jmhigh2/micromouseIFC/python/maze2008.jpg

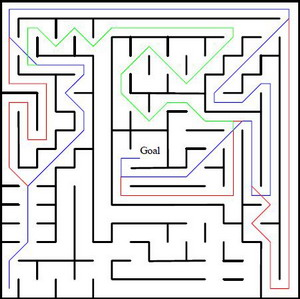
python/maze2008.jpg
