jmhigh2/micromouseIFC/GreenGiant_MIN7/Green Giant V4.2 Schematic.pdf

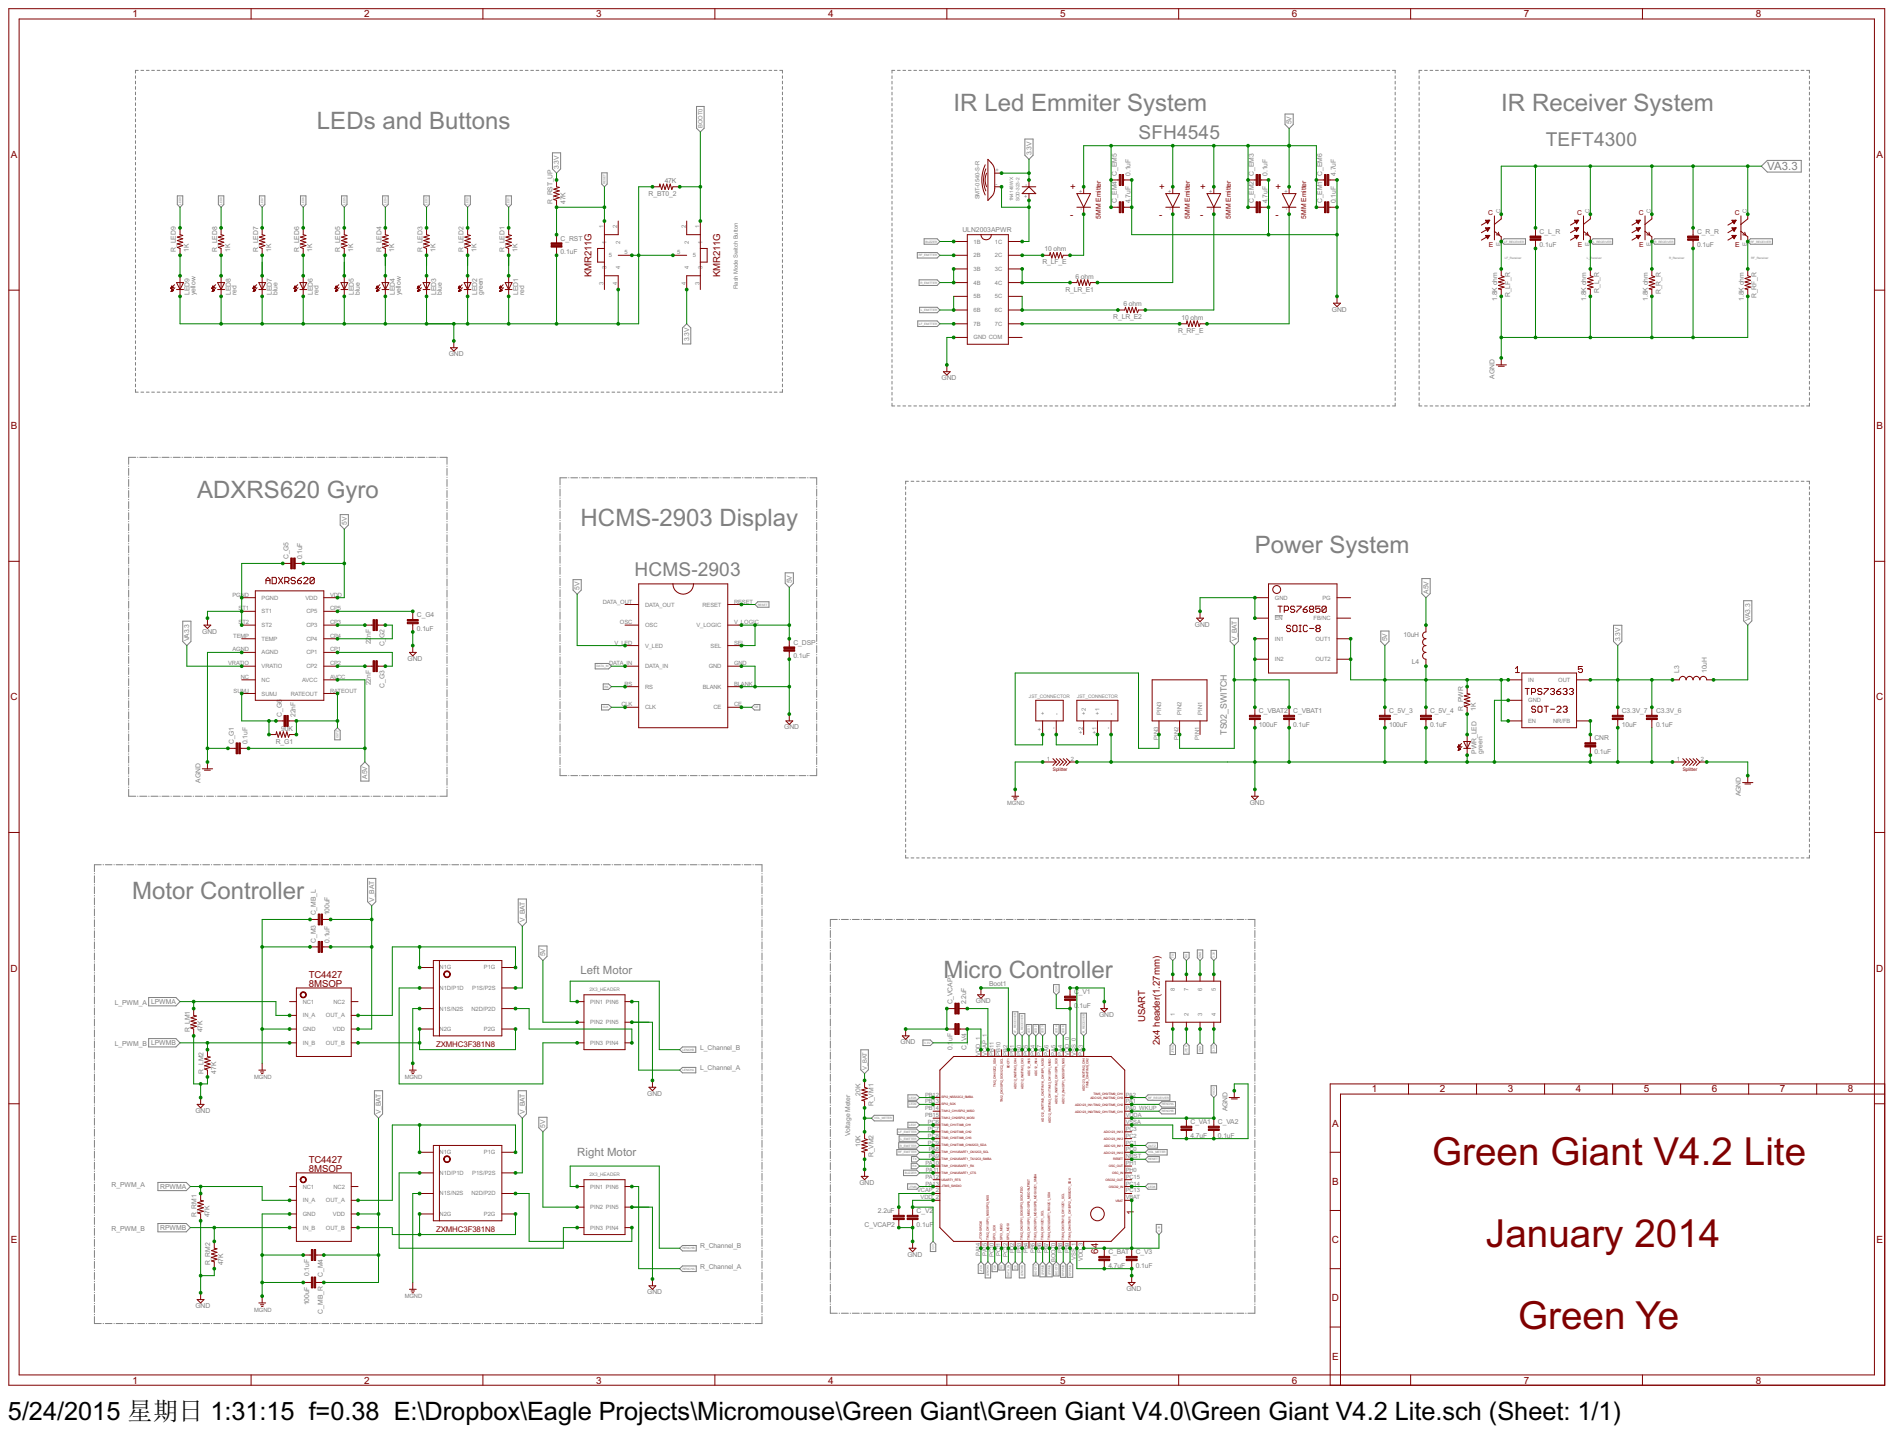
[picture p2: page 1]

MGND | LENCHB

5/24/2015 星期日 1:31:15 f=0.38 E:\Dropbox\Eagle Projects\Micromouse\Green Giant\Green Giant V4.0\Green Giant V4.2 Lite.sch (Sheet: 1/1)
