jmhigh2/micromouseIFC/GreenGiant_MIN7/MIN7-Schematic.pdf

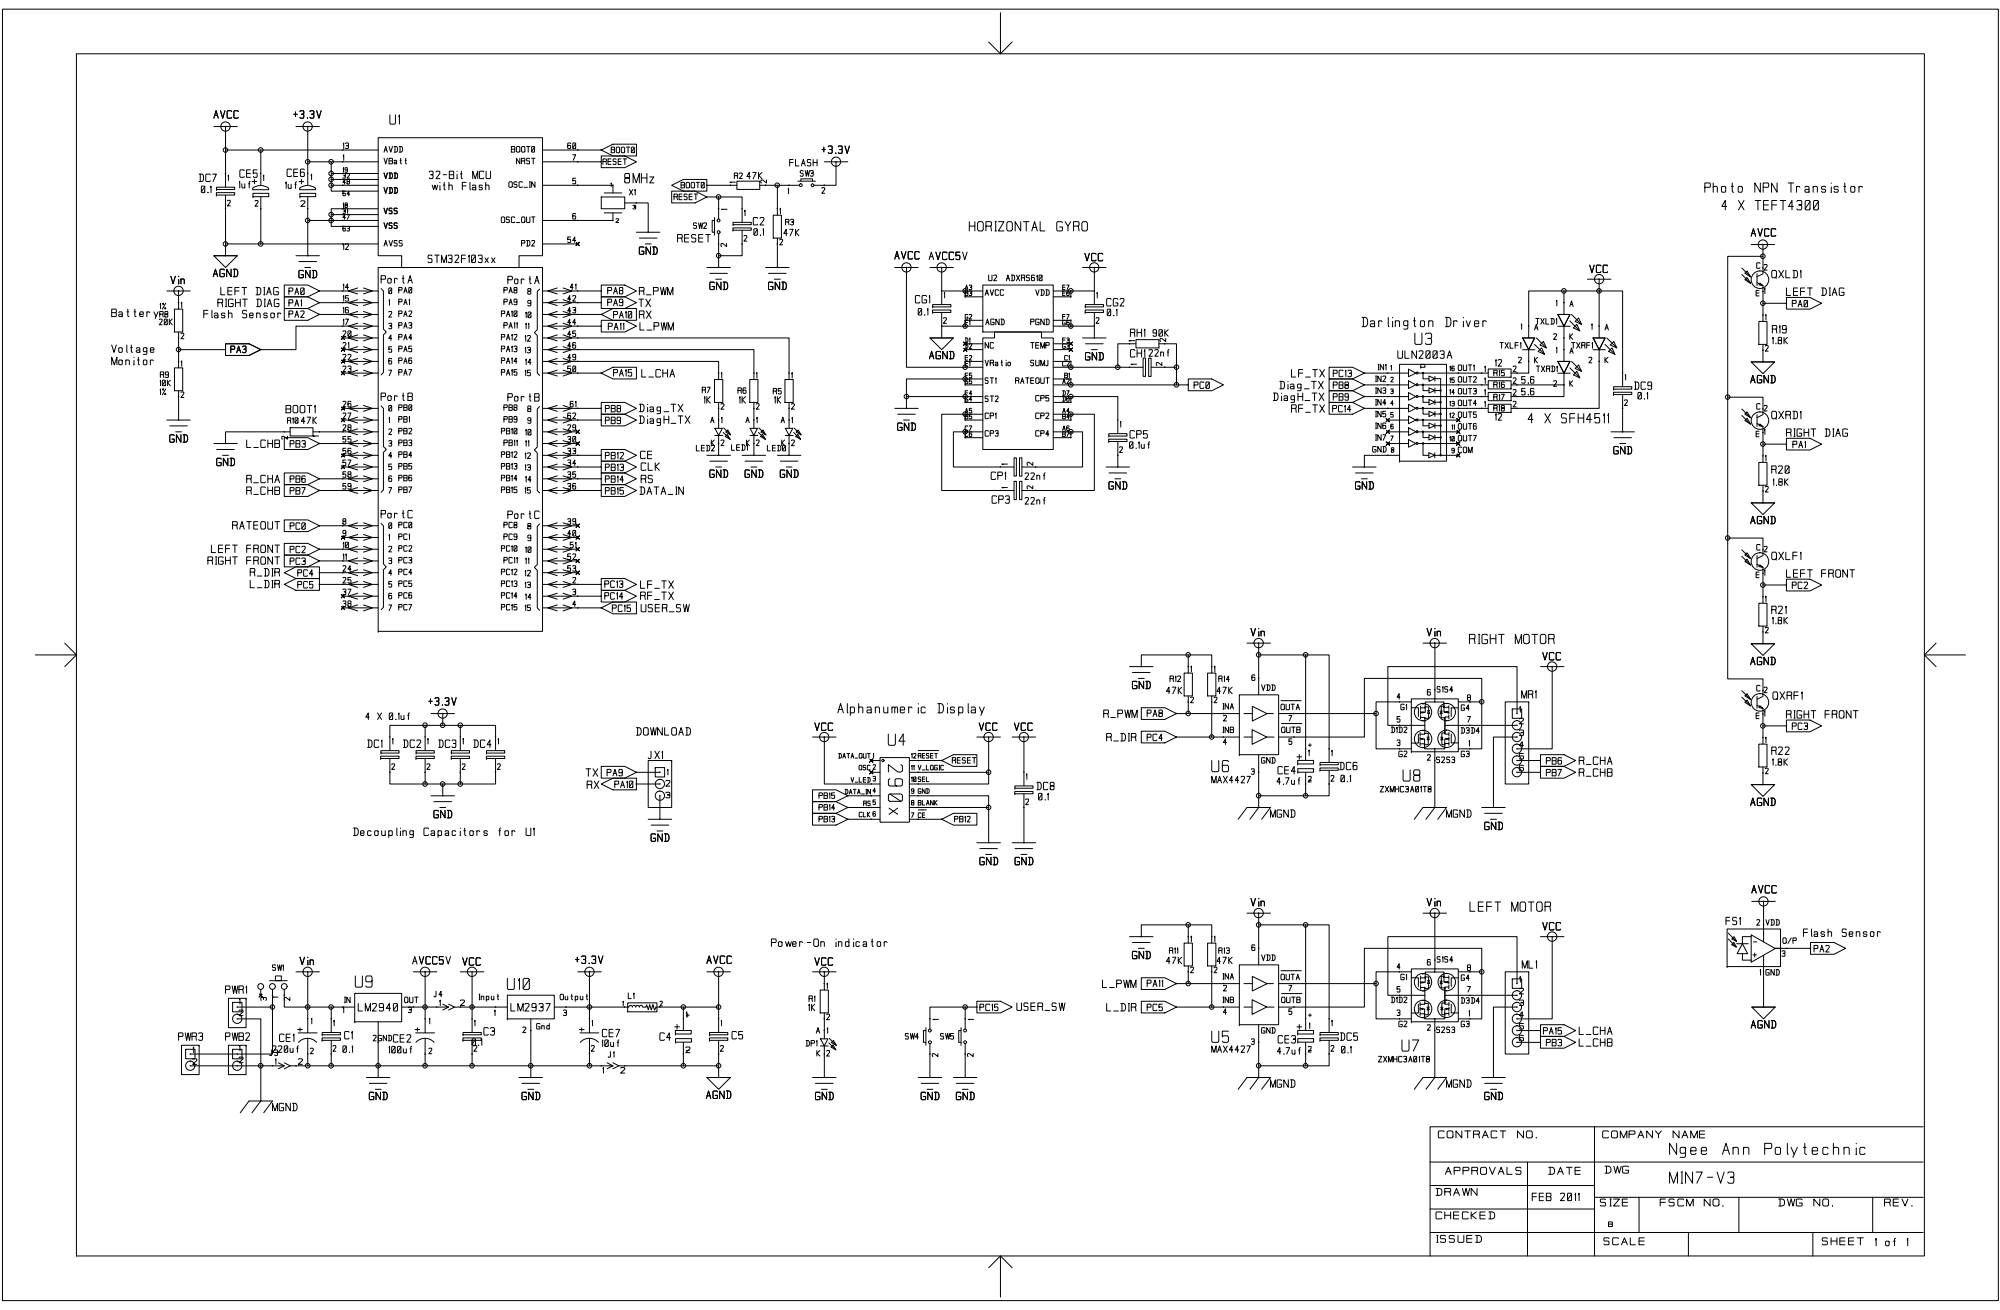
[picture p3: page 1]
