jmhigh2/micromouseIFC/MouseRev100000/MoueRev3.brd

## EAGLE design MouseRev100000/MoueRev3.brd (2017-03-13)

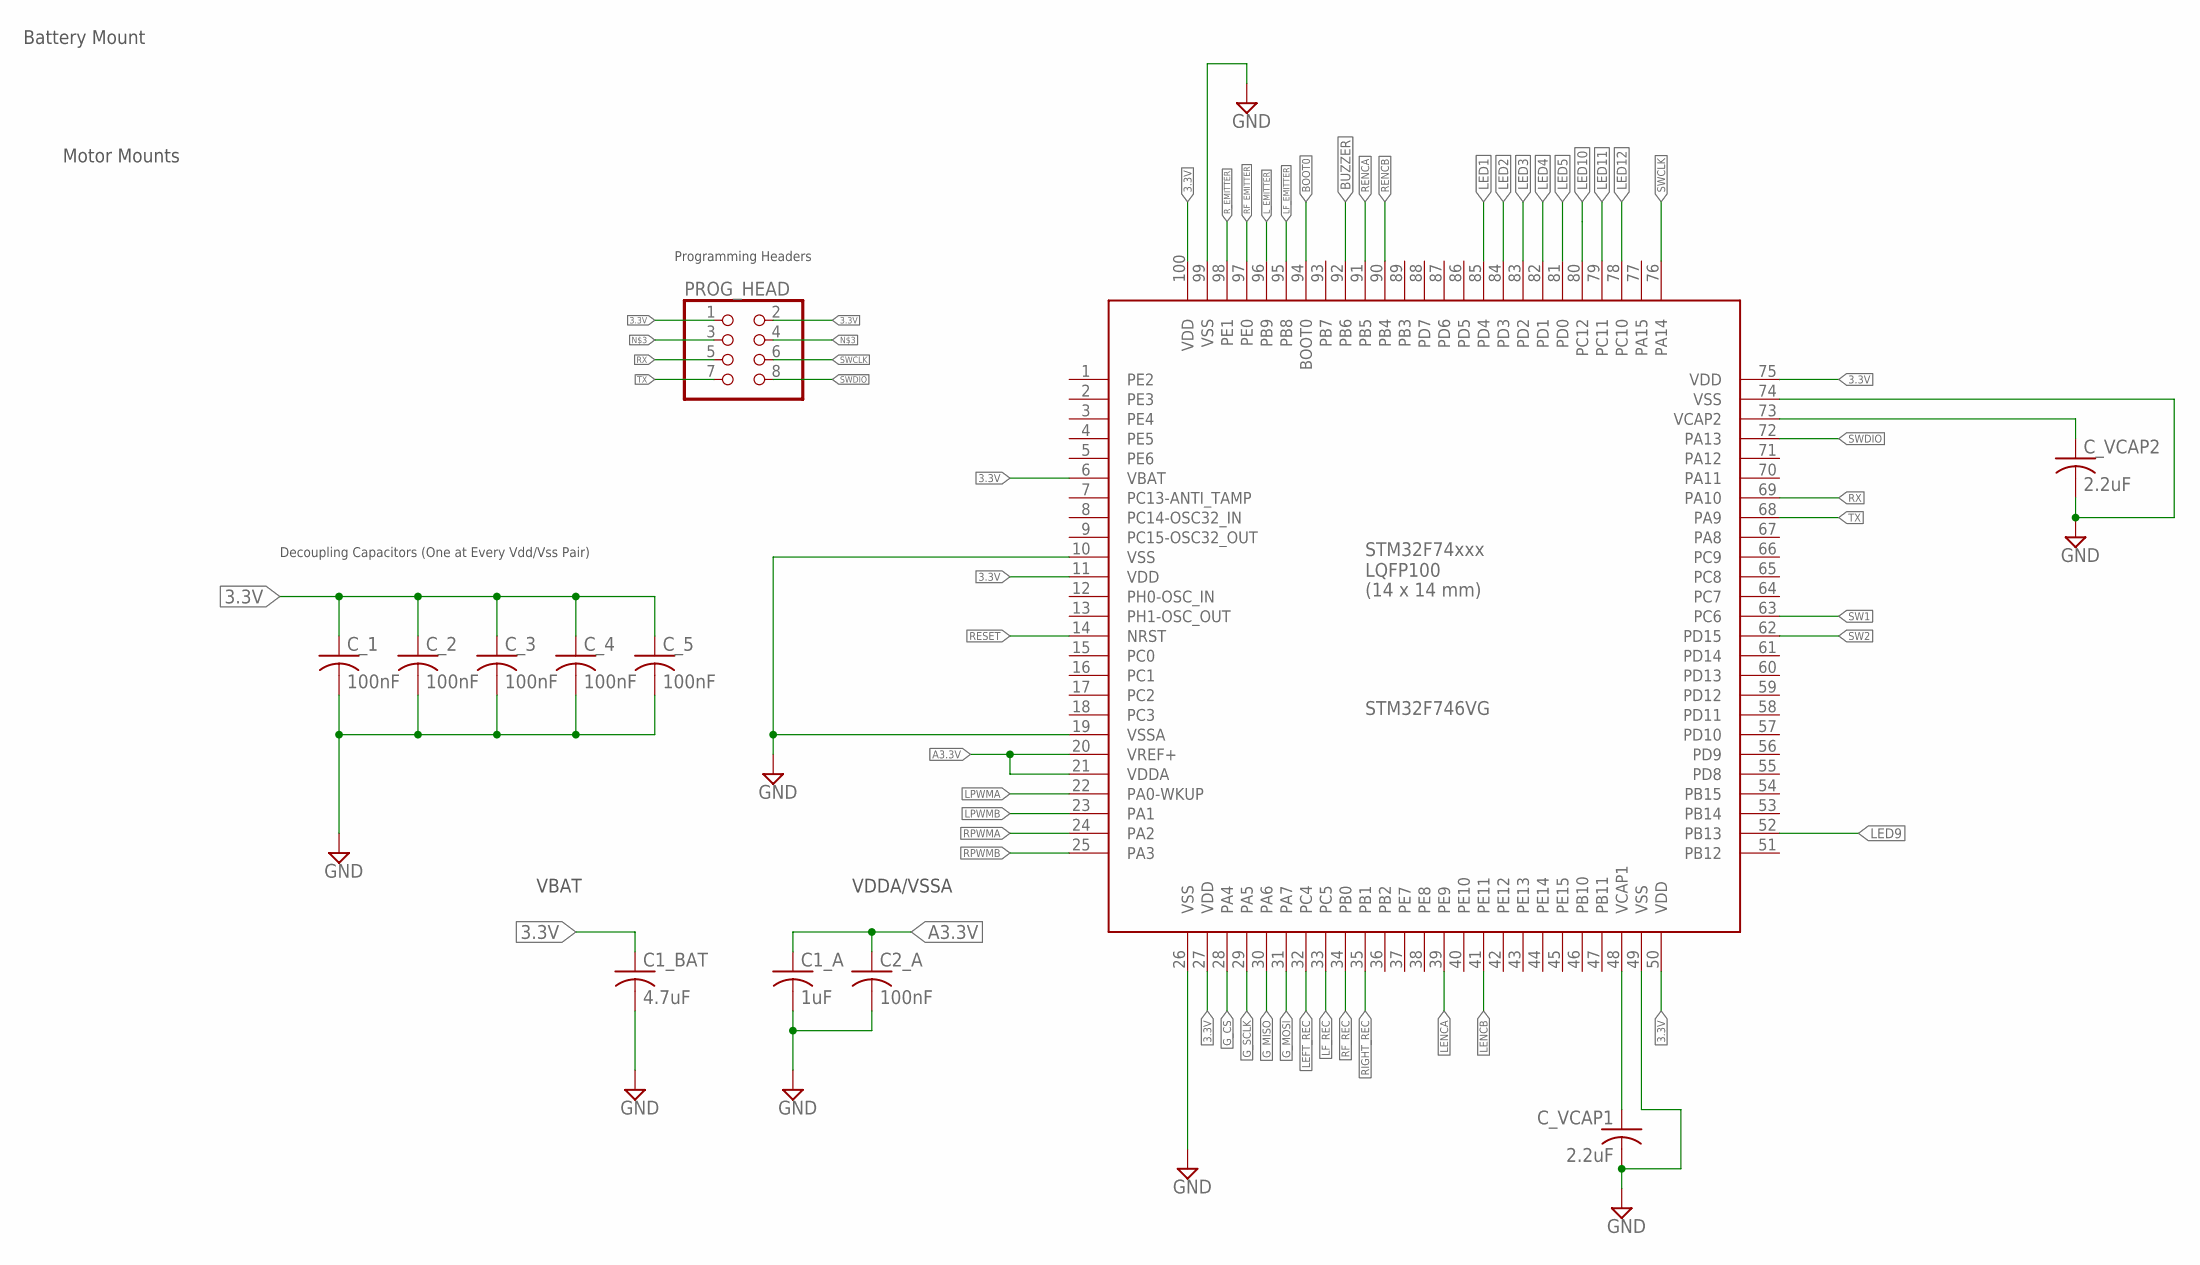
[picture p4: schematic MoueRev3.sch, sheet 1, MicroController]

Parts:
C1_A: 1uF; C0603
C1_BAT: 4.7uF; C0603
C2_A: 100nF; C0603
C_1, C_2, C_3, C_4, C_5: 100nF; C0603
C_VCAP1, C_VCAP2: 2.2uF; C0603
PROG_HEAD: PINHD-2X4; 2X04
U$2: MOTOR; MOTOR_MOUNT
U$3: STM32F746VG; LQFP100

Connections:
3.3V: C1_BAT.1, C_1.1, C_2.1, C_3.1, C_4.1, C_5.1, PROG_HEAD.1, PROG_HEAD.2, U$3.6 (VBAT), U$3.11 (VDD), U$3.27 (VDD), U$3.50 (VDD), U$3.75 (VDD), U$3.100 (VDD); also elsewhere on the board
A3.3V: C1_A.1, C2_A.1, U$3.20 (VREF+), U$3.21 (VDDA); also elsewhere on the board
BOOT0: U$3.94 (BOOT0); also elsewhere on the board
BUZZER: U$3.92 (PB6); also elsewhere on the board
G_CS: U$3.28 (PA4); also elsewhere on the board
G_MISO: U$3.30 (PA6); also elsewhere on the board
G_MOSI: U$3.31 (PA7); also elsewhere on the board
G_SCLK: U$3.29 (PA5); also elsewhere on the board
LED1: U$3.85 (PD4); also elsewhere on the board
LED2: U$3.84 (PD3); also elsewhere on the board
LED3: U$3.83 (PD2); also elsewhere on the board
LED4: U$3.82 (PD1); also elsewhere on the board
LED5: U$3.81 (PD0); also elsewhere on the board
LED9: U$3.52 (PB13); also elsewhere on the board
LED10: U$3.80 (PC12); also elsewhere on the board
LED11: U$3.79 (PC11); also elsewhere on the board
LED12: U$3.78 (PC10); also elsewhere on the board
LEFT_REC: U$3.32 (PC4); also elsewhere on the board
LENCA: U$3.39 (PE9); also elsewhere on the board
LENCB: U$3.41 (PE11); also elsewhere on the board
LF_EMITTER: U$3.95 (PB8); also elsewhere on the board
LF_REC: U$3.33 (PC5); also elsewhere on the board
LPWMA: U$3.22 (PA0-WKUP); also elsewhere on the board
LPWMB: U$3.23 (PA1); also elsewhere on the board
L_EMITTER: U$3.96 (PB9); also elsewhere on the board
unnamed 30: C1_A.2, C1_BAT.2, C2_A.2, C_1.2, C_2.2, C_3.2, C_4.2, C_5.2, C_VCAP1.2, C_VCAP2.2, PROG_HEAD.3, PROG_HEAD.4, U$3.10 (VSS), U$3.19 (VSSA), U$3.26 (VSS), U$3.49 (VSS), U$3.74 (VSS), U$3.99 (VSS); also elsewhere on the board
unnamed: C_VCAP2.1, U$3.73 (VCAP2)
unnamed: C_VCAP1.1, U$3.48 (VCAP1)
RENCA: U$3.91 (PB5); also elsewhere on the board
RENCB: U$3.90 (PB4); also elsewhere on the board
RESET: U$3.14 (NRST); also elsewhere on the board
RF_EMITTER: U$3.97 (PE0); also elsewhere on the board
RF_REC: U$3.34 (PB0); also elsewhere on the board
RIGHT_REC: U$3.35 (PB1); also elsewhere on the board
RPWMA: U$3.24 (PA2); also elsewhere on the board
RPWMB: U$3.25 (PA3); also elsewhere on the board
RX: PROG_HEAD.5, U$3.69 (PA10)
R_EMITTER: U$3.98 (PE1); also elsewhere on the board
SW1: U$3.63 (PC6)
SW2: U$3.62 (PD15)
SWCLK: PROG_HEAD.6, U$3.76 (PA14)
SWDIO: PROG_HEAD.8, U$3.72 (PA13)
TX: PROG_HEAD.7, U$3.68 (PA9)

Notes on the sheet:
Decoupling Capacitors (One at Every Vdd/Vss Pair)
Programming Headers
VDDA/VSSA
VBAT
Battery Mount
Motor Mounts

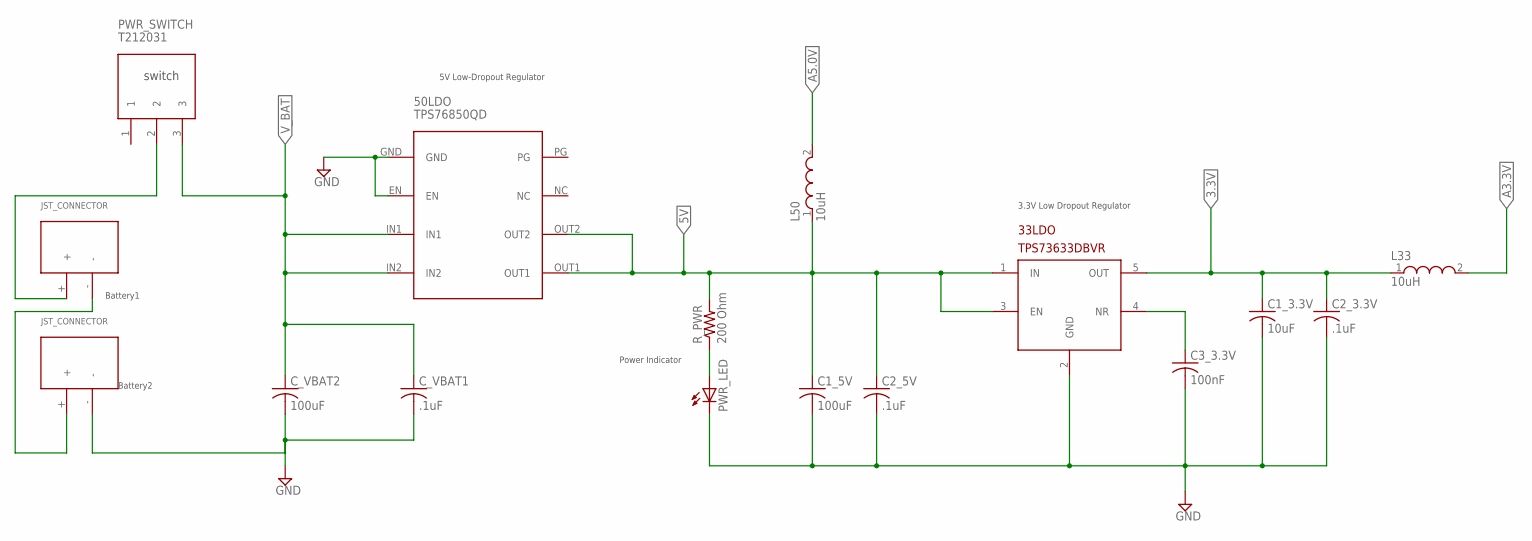
[picture p5: schematic MoueRev3.sch, sheet 2, Power Supply]

Parts:
33LDO: TPS73633DBVR; SOT23-DBV
50LDO: TPS76850QD; 8-SOIC(SMT)
C1_3.3V: 10uF; C0603
C1_5V: 100uF; C0603
C2_3.3V, C2_5V: .1uF; C0603
C3_3.3V: 100nF; C0603
C_VBAT1: .1uF; C0603
C_VBAT2: 100uF; C1206
L33, L50: 10uH; WE-MI_0805
PWR_LED: LEDCHIPLED_0805; CHIPLED_0805
PWR_SWITCH: T212031
R_PWR: 200 Ohm; R0603
U$7, U$8: JST_CONNECTOR_FEMALE

Connections:
3.3V: 33LDO.5 (OUT), C1_3.3V.1, C2_3.3V.1, L33.1; also elsewhere on the board
5V: 33LDO.1 (IN), 33LDO.3 (EN), 50LDO.OUT1, 50LDO.OUT2, C1_5V.1, C2_5V.1, L50.1, R_PWR.2; also elsewhere on the board
A3.3V: L33.2; also elsewhere on the board
A5.0V: L50.2; also elsewhere on the board
unnamed: PWR_LED.A, R_PWR.1
unnamed: 33LDO.4 (NR), C3_3.3V.1
unnamed 30: 33LDO.2 (GND), 50LDO.EN, 50LDO.GND, C1_3.3V.2, C1_5V.2, C2_3.3V.2, C2_5V.2, C3_3.3V.2, C_VBAT1.2, C_VBAT2.2, PWR_LED.C, U$8.-; also elsewhere on the board
unnamed: U$7.-, U$8.+
unnamed: PWR_SWITCH.2, U$7.+
V_BAT: 50LDO.IN1, 50LDO.IN2, C_VBAT1.1, C_VBAT2.1, PWR_SWITCH.3; also elsewhere on the board

Notes on the sheet:
Battery1
Battery2
5V Low-Dropout Regulator
3.3V Low Dropout Regulator
Power Indicator
switch

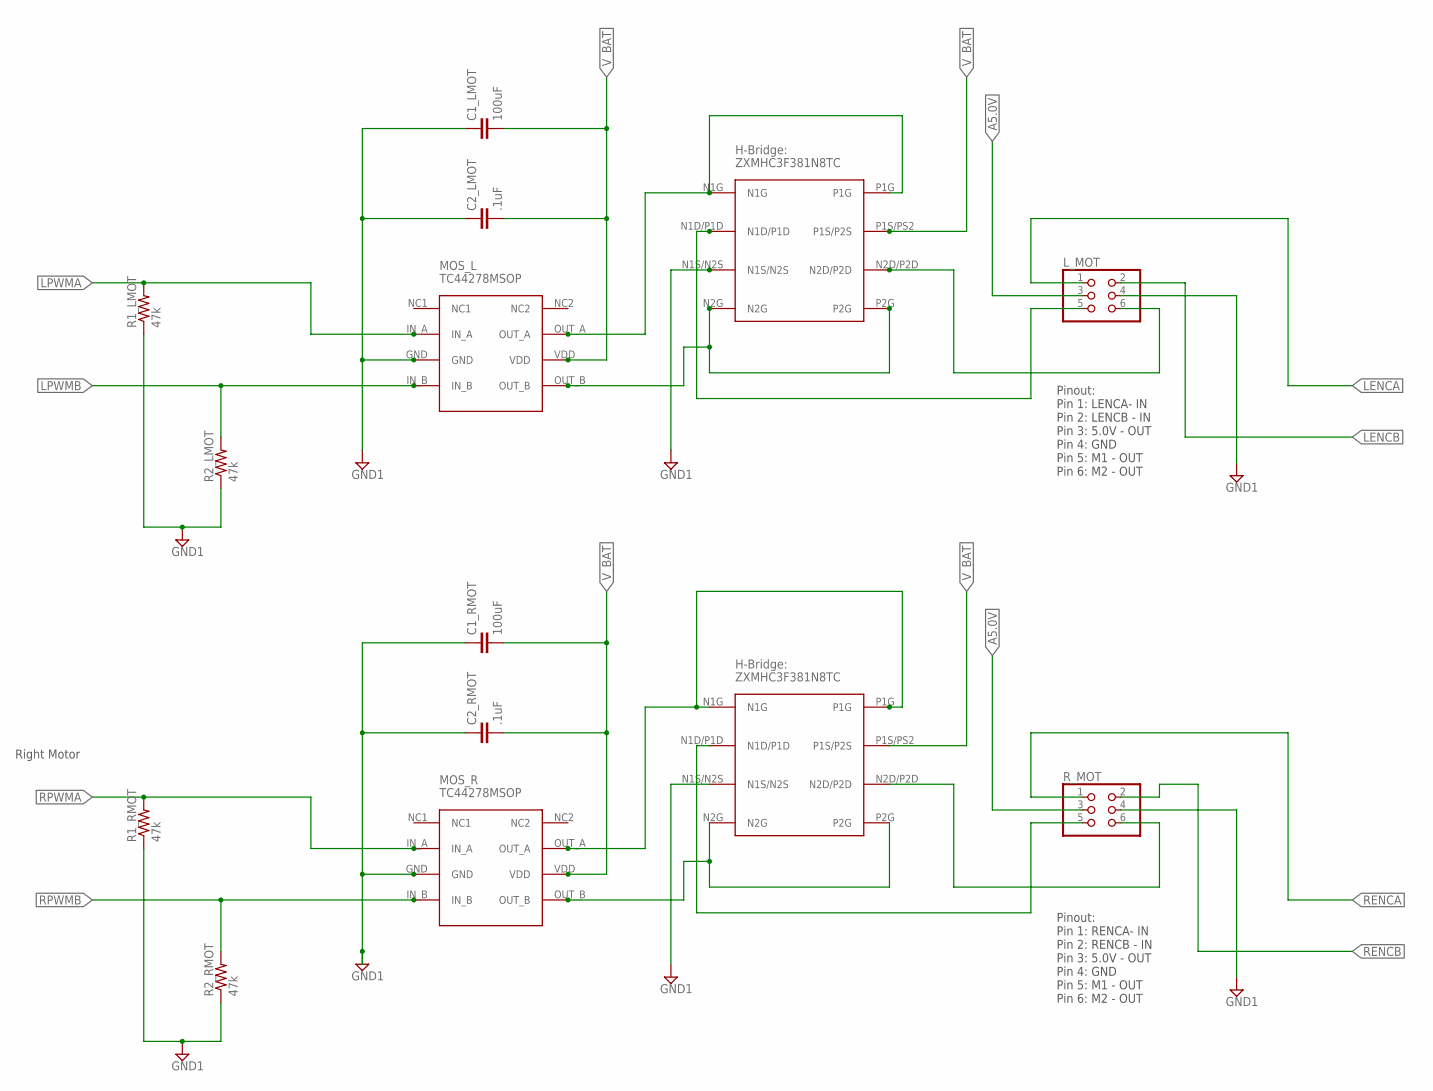
[picture p6: schematic MoueRev3.sch, sheet 3, Motor Control]

Parts:
C1_LMOT, C1_RMOT: 100uF; C1206
C2_LMOT, C2_RMOT: .1uF; C0805
HB_L: ZXMHC3F381N8TC; 8-SOIC
HB_R: ZXMHC3F381N8TC; 8-SOIC
L_MOT: PINHD-2X3; 2X03
MOS_L: TC44278MSOP
MOS_R: TC44278MSOP
R1_LMOT, R1_RMOT, R2_LMOT, R2_RMOT: 47k; R0603
R_MOT: PINHD-2X3; 2X03

Connections:
A5.0V: L_MOT.3, R_MOT.3; also elsewhere on the board
LENCA: L_MOT.1; also elsewhere on the board
LENCB: L_MOT.2; also elsewhere on the board
LPWMA: MOS_L.IN_A, R1_LMOT.2; also elsewhere on the board
LPWMB: MOS_L.IN_B, R2_LMOT.2; also elsewhere on the board
unnamed 30: C1_LMOT.1, C1_RMOT.1, C2_LMOT.1, C2_RMOT.1, HB_L.N1S/N2S, HB_R.N1S/N2S, L_MOT.4, MOS_L.GND, MOS_R.GND, R1_LMOT.1, R1_RMOT.1, R2_LMOT.1, R2_RMOT.1, R_MOT.4; also elsewhere on the board
unnamed: HB_L.N1G, HB_L.P1G, MOS_L.OUT_A
unnamed: HB_L.N2G, HB_L.P2G, MOS_L.OUT_B
unnamed: HB_R.N1G, HB_R.P1G, MOS_R.OUT_A
unnamed: HB_L.N1D/P1D, L_MOT.5
unnamed: HB_L.N2D/P2D, L_MOT.6
unnamed: HB_R.N2G, HB_R.P2G, MOS_R.OUT_B
unnamed: HB_R.N1D/P1D, R_MOT.5
unnamed: HB_R.N2D/P2D, R_MOT.6
RENCA: R_MOT.1; also elsewhere on the board
RENCB: R_MOT.2; also elsewhere on the board
RPWMA: MOS_R.IN_A, R1_RMOT.2; also elsewhere on the board
RPWMB: MOS_R.IN_B, R2_RMOT.2; also elsewhere on the board
V_BAT: C1_LMOT.2, C1_RMOT.2, C2_LMOT.2, C2_RMOT.2, HB_L.P1S/PS2 (P1S/P2S), HB_R.P1S/PS2 (P1S/P2S), MOS_L.VDD, MOS_R.VDD; also elsewhere on the board

Notes on the sheet:
Pinout: Pin 1: LENCA- IN Pin 2: LENCB - IN Pin 3: 5.0V - OUT Pin 4: GND Pin 5: M1 - OUT Pin 6: M2 - OUT
Right Motor
Pinout: Pin 1: RENCA- IN Pin 2: RENCB - IN Pin 3: 5.0V - OUT Pin 4: GND Pin 5: M1 - OUT Pin 6: M2 - OUT

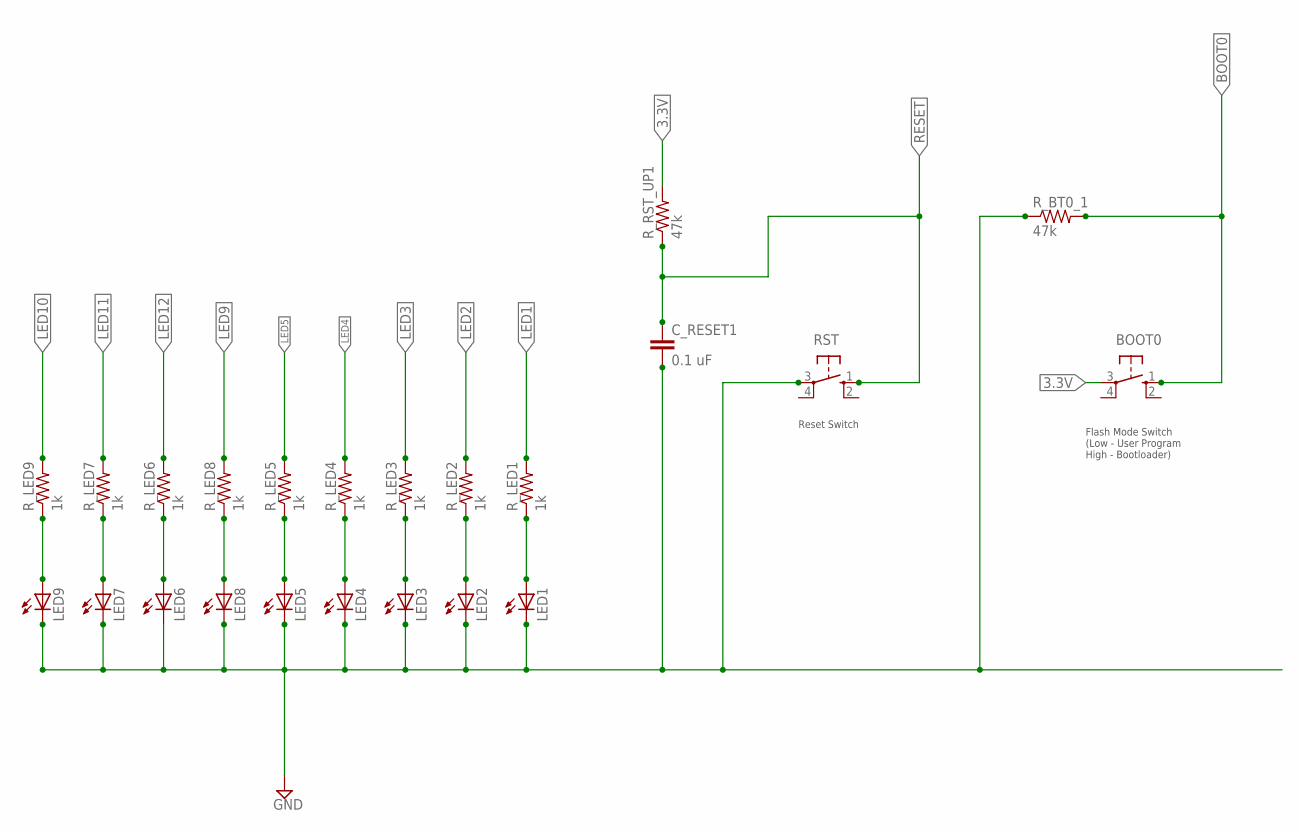
[picture p7: schematic MoueRev3.sch, sheet 4, LED's and Buttons]

Parts:
BOOT0: 10-XX; B3F-10XX
C_RESET1: 0.1 uF; C0603
LED1, LED2, LED3, LED4, LED5, LED6, LED7, LED8, LED9: LEDCHIPLED_0805; CHIPLED_0805
RST: 10-XX; B3F-10XX
R_BT0_1: 47k; R0603
R_LED1, R_LED2, R_LED3, R_LED4, R_LED5, R_LED6, R_LED7, R_LED8, R_LED9: 1k; R0603
R_RST_UP1: 47k; R0603

Connections:
3.3V: BOOT0.3, R_RST_UP1.2; also elsewhere on the board
BOOT0: BOOT0.1 (S), R_BT0_1.2; also elsewhere on the board
GND: C_RESET1.2, LED1.C, LED2.C, LED3.C, LED4.C, LED5.C, LED6.C, LED7.C, LED8.C, LED9.C, RST.3, R_BT0_1.1
LED1: R_LED1.2; also elsewhere on the board
LED2: R_LED2.2; also elsewhere on the board
LED3: R_LED3.2; also elsewhere on the board
LED4: R_LED4.2; also elsewhere on the board
LED5: R_LED5.2; also elsewhere on the board
LED9: R_LED8.2; also elsewhere on the board
LED10: R_LED9.2; also elsewhere on the board
LED11: R_LED7.2; also elsewhere on the board
LED12: R_LED6.2; also elsewhere on the board
unnamed: LED8.A, R_LED8.1
unnamed: LED6.A, R_LED6.1
unnamed: LED7.A, R_LED7.1
unnamed: LED9.A, R_LED9.1
unnamed: LED1.A, R_LED1.1
unnamed: LED2.A, R_LED2.1
unnamed: LED3.A, R_LED3.1
unnamed: LED4.A, R_LED4.1
unnamed: LED5.A, R_LED5.1
RESET: C_RESET1.1, RST.1 (S), R_RST_UP1.1; also elsewhere on the board

Notes on the sheet:
Reset Switch
Flash Mode Switch (Low - User Program High - Bootloader)

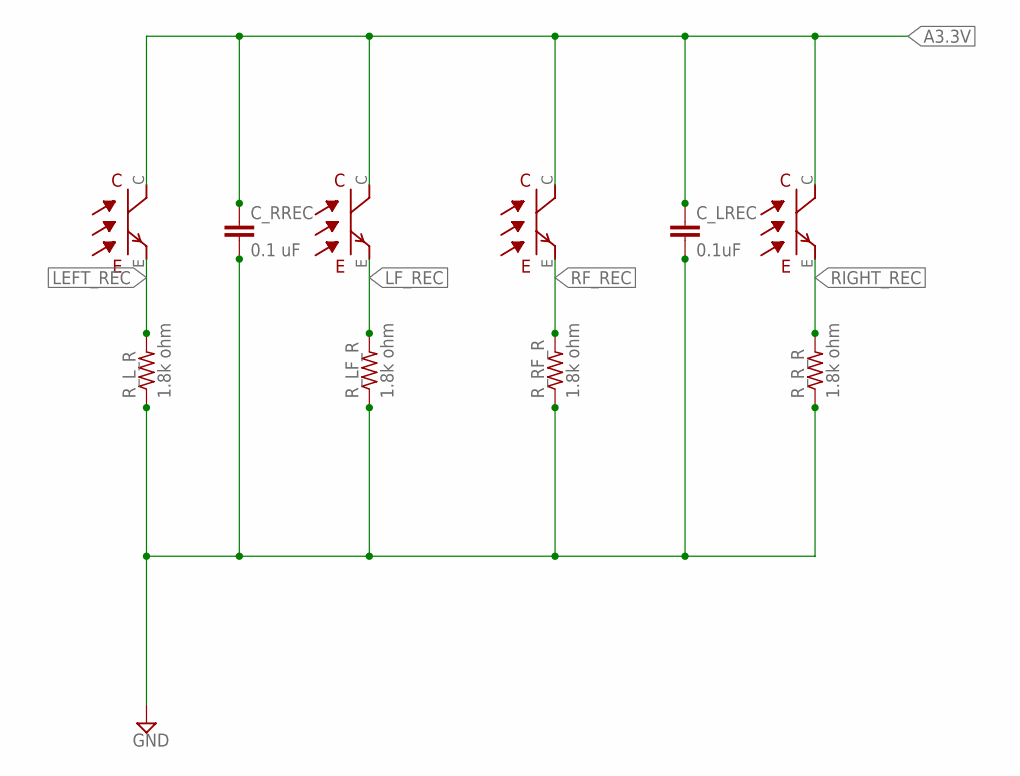
[picture p8: schematic MoueRev3.sch, sheet 5, Infrared Receivers]

Parts:
C_LREC: 0.1uF; C0603
C_RREC: 0.1 uF; C0603
LF_REC: RECEIVER
L_REC: RECEIVER
RF_REC: RECEIVER
R_LF_R: 1.8k ohm; R0603
R_L_R: 1.8k ohm; R0603
R_REC: RECEIVER
R_RF_R: 1.8k ohm; R0603
R_R_R: 1.8k ohm; R0603

Connections:
A3.3V: C_LREC.1, C_RREC.1, LF_REC.C, L_REC.C, RF_REC.C, R_REC.C; also elsewhere on the board
LEFT_REC: L_REC.E, R_L_R.2; also elsewhere on the board
LF_REC: LF_REC.E, R_LF_R.2; also elsewhere on the board
unnamed 30: C_LREC.2, C_RREC.2, R_LF_R.1, R_L_R.1, R_RF_R.1, R_R_R.1; also elsewhere on the board
RF_REC: RF_REC.E, R_RF_R.2; also elsewhere on the board
RIGHT_REC: R_REC.E, R_R_R.2; also elsewhere on the board

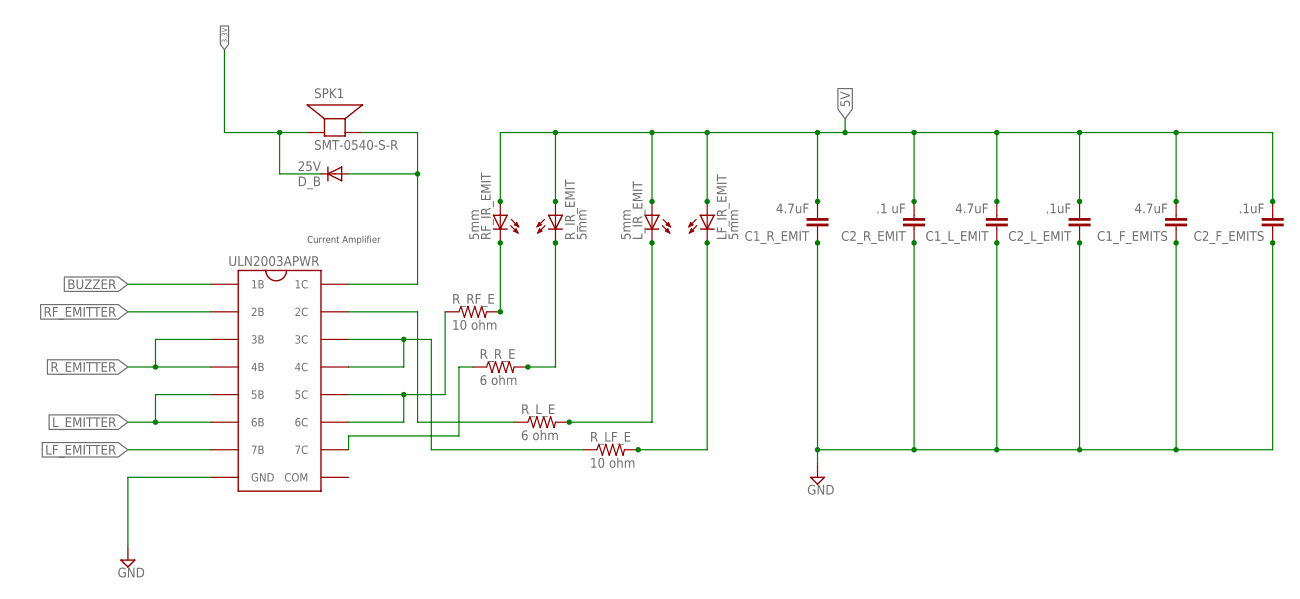
[picture p9: schematic MoueRev3.sch, sheet 6, Infrared Emitters]

Parts:
C1_F_EMITS, C1_L_EMIT, C1_R_EMIT: 4.7uF; C0603
C2_F_EMITS, C2_L_EMIT: .1uF; C0603
C2_R_EMIT: .1 uF; C0603
D_B: 25V; SOD123
LF_IR_EMIT: 5mm; LED5MM
L_IR_EMIT: 5mm; LED5MM
RF_IR_EMIT: 5mm; LED5MM
R_IR_EMIT: 5mm; LED5MM
R_LF_E: 10 ohm; R0603
R_L_E: 6 ohm; R0603
R_RF_E: 10 ohm; R0603
R_R_E: 6 ohm; R0603
SPK1: SMT-0540-S-R
U$9: ULN2003APWR

Connections:
3.3V: D_B.C, SPK1.- (+); also elsewhere on the board
5V: C1_F_EMITS.2, C1_L_EMIT.2, C1_R_EMIT.2, C2_F_EMITS.2, C2_L_EMIT.2, C2_R_EMIT.2, LF_IR_EMIT.A, L_IR_EMIT.A, RF_IR_EMIT.A, R_IR_EMIT.A; also elsewhere on the board
BUZZER: U$9.1B; also elsewhere on the board
LF_EMITTER: U$9.7B; also elsewhere on the board
L_EMITTER: U$9.5B, U$9.6B; also elsewhere on the board
unnamed 30: C1_F_EMITS.1, C1_L_EMIT.1, C1_R_EMIT.1, C2_F_EMITS.1, C2_L_EMIT.1, C2_R_EMIT.1, U$9.GND; also elsewhere on the board
unnamed: R_L_E.1, U$9.2C
unnamed: R_R_E.1, U$9.7C
unnamed: RF_IR_EMIT.K (C), R_RF_E.2
unnamed: R_LF_E.1, U$9.3C, U$9.4C
unnamed: R_IR_EMIT.K (C), R_R_E.2
unnamed: L_IR_EMIT.K (C), R_L_E.2
unnamed: R_RF_E.1, U$9.5C, U$9.6C
unnamed: LF_IR_EMIT.K (C), R_LF_E.2
unnamed: D_B.A, SPK1.+ (-), U$9.1C
RF_EMITTER: U$9.2B; also elsewhere on the board
R_EMITTER: U$9.3B, U$9.4B; also elsewhere on the board

Notes on the sheet:
Current Amplifier

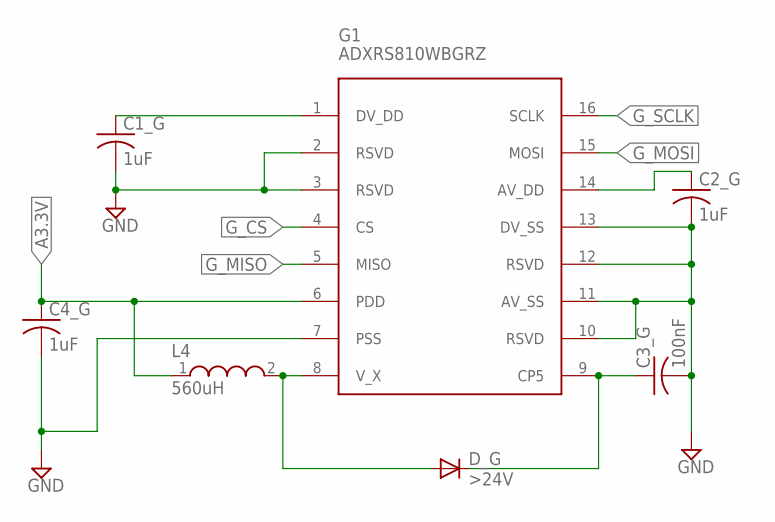
[picture p10: schematic MoueRev3.sch, sheet 7, Gyroscope]

Parts:
C1_G, C2_G, C4_G: 1uF; C0603
C3_G: 100nF; C0603
D_G: >24V; SOD123
G1: ADXRS810; SOIC-16
L4: 560uH; WE-MI_1206

Connections:
A3.3V: C4_G.1, G1.6 (PDD), L4.1; also elsewhere on the board
G_CS: G1.4 (CS); also elsewhere on the board
G_MISO: G1.5 (MISO); also elsewhere on the board
G_MOSI: G1.15 (MOSI); also elsewhere on the board
G_SCLK: G1.16 (SCLK); also elsewhere on the board
unnamed 30: C1_G.2, C2_G.2, C3_G.2, C4_G.2, G1.2 (RSVD), G1.3 (RSVD), G1.7 (PSS), G1.10 (RSVD), G1.11 (AV_SS), G1.12 (RSVD), G1.13 (DV_SS); also elsewhere on the board
unnamed: C1_G.1, G1.1 (DV_DD)
unnamed: D_G.A, G1.8 (V_X), L4.2
unnamed: C3_G.1, D_G.C, G1.9 (CP5)
unnamed: C2_G.1, G1.14 (AV_DD)

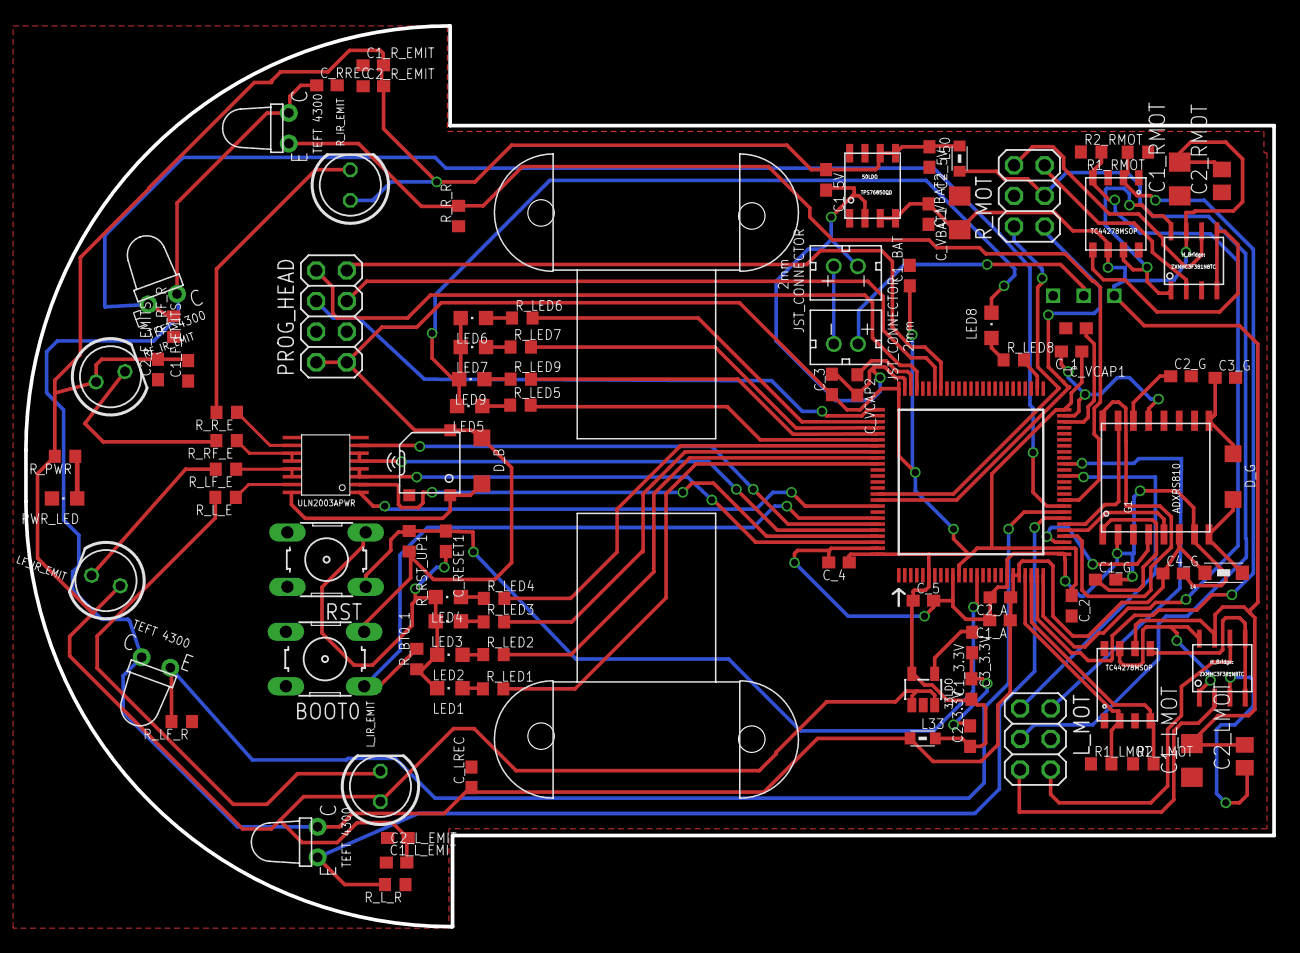
[picture p11: board MoueRev3.brd from above]

Board: 2 copper layers, 103.7 x 74.8 mm, 101 parts (0 on the bottom side), 79 nets.

Other parts of the board:
U$1: MOTOR; MOTOR_MOUNT
