jmhigh2/micromouseIFC/(commit log)

2016-10-06 Eagle Folder
    [master.sch]
2016-10-18 Linear Regulators
    [master.sch]
2016-10-25 Microcontoller Schem
    [master2.sch]
2016-10-25 LED schematic and Motor Driver Schematic that is named power for some reason
    [LED.sch, MMPower.sch]
2016-10-25 IR receiver system
    [MMIRRecSys.sch]
2016-10-27 Merged into Master
    [LEDs.sch, master_schematic.sch, motor_controller.sch, receiver_system.sch]
2016-10-27 New Schematic
    [master_schematic.sch]
2016-12-02 ir led schematic emitter
    [MMIrLedEm.sch]
2016-12-06 Updated Schematic + Gyroscope
    [master_schematic.brd, master_schematic.sch]
2016-12-10 Added Buzzer
    [master_schematic.brd, master_schematic.sch]
2016-12-20 Fixed Inductors
    [master_schematic.sch]
2016-12-24 Motor and Battery Mount
    [master_schematic.sch]
2016-12-27 ULN and stuff
    [master_schematic.sch]
2017-01-07 Schematic Update
    [master_schematic.sch]
2017-01-16 check before purchase
    [master_schematic_basic4.brd]
2017-01-20 hex file
    [motor_controller.sch, rev2.brd, rev2.sch]
2017-02-02 Clean directory
    [rev2.brd, rev2.sch]
2017-02-10 Revision 2 Schem + Board + GERBS
    [rev2.brd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]
2017-02-27 mouse revision # 3
    [MoueRev3.brd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]
2017-03-06 Final Board
    [MoueRev3.brd, MoueRev3.sch]
2017-03-13 NEW PUSH
    [MoueRev3.brd]
2017-03-13 Last Revision allegedly
    [MoueRev3.brd, MoueRev3.sch]
