jmhigh2/micromouseIFC/(notices)

Notices in the files:
parts and their libraries:
EagleLibrary_Wuerth_Elektronik_eiSos_rev: Copyright: Würth Elektronik
